OlliL/P8000_WDC_Emulator/performance.txt

----------------------- SD-Card Apacer SD 60x 2GB ----------------------- 
AP2GSD60
540824525053
S482C002GRFBB
0823080523092

=== P8000 WDC Emulator 2.10 - 2016-06-26 ===
INFO: SDCard init start
INFO: SD2.0 disk with byte addressing has been found
INFO: Performance Measurement.
Test Read 5000 512B-Blocks with Multiblock-Read (4KB Blocksize):
536.583070 KiB/sec
536.659850 KiB/sec
Test Write 5000 512B-Blocks with Singleblock-Write (512B Blocksize):
90.717392 KiB/sec
92.806076 KiB/sec
Test Read 5000 512B-Blocks with Singleblock-Read (512B Blocksize):
380.420990 KiB/sec
380.543240 KiB/sec
Test Write 5000 512B-Blocks with Singleblock-Write (512B Blocksize):
91.719177 KiB/sec
92.618126 KiB/sec
Test Read 5000 512B-Blocks with Multiblock-Read (4KB Blocksize):
543.517640 KiB/sec
543.911870 KiB/sec
Test Write 5000 512B-Blocks with Multiblock-Write (4KB Blocksize):
342.564820 KiB/sec
341.265870 KiB/sec
Test Read 5000 512B-Blocks with Multiblock-Read (4KB Blocksize):
534.899230 KiB/sec
534.899230 KiB/sec
Test Write 5000 512B-Blocks with Singleblock-Write (512B Blocksize):
89.257736 KiB/sec
92.855103 KiB/sec
Test Write 5000 512B-Blocks with Multiblock-Write (4KB Blocksize):
343.915740 KiB/sec
334.951020 KiB/sec
Test Read 5000 512B-Blocks with Singleblock-Read (512B Blocksize):
354.962370 KiB/sec
354.973570 KiB/sec
Test Read 5000 512B-Blocks with Multiblock-Read (4KB Blocksize):
532.897520 KiB/sec
532.859680 KiB/sec
Test Read 5000 512B-Blocks with Singleblock-Read (512B Blocksize):
354.939970 KiB/sec
354.956760 KiB/sec
Test Write 5000 512B-Blocks with Multiblock-Write (4KB Blocksize):
327.821080 KiB/sec
326.167330 KiB/sec
Test Write 5000 512B-Blocks with Singleblock-Write (512B Blocksize):
90.930397 KiB/sec
90.952820 KiB/sec
End

----------------------- SD-Card Transcend SD 2GB ----------------------- 
6451AG 2G 02DS1
1555528 8163

=== P8000 WDC Emulator 2.10 - 2016-06-26 ===
INFO: SDCard init start
INFO: SDSC disk has been found
INFO: Performance Measurement.
Test Read 5000 512B-Blocks with Multiblock-Read (4KB Blocksize):
551.375980 KiB/sec
553.478270 KiB/sec
Test Write 5000 512B-Blocks with Singleblock-Write (512B Blocksize):
122.884340 KiB/sec
123.012660 KiB/sec
Test Read 5000 512B-Blocks with Singleblock-Read (512B Blocksize):
400.256160 KiB/sec
400.249020 KiB/sec
Test Write 5000 512B-Blocks with Singleblock-Write (512B Blocksize):
123.345790 KiB/sec
123.431720 KiB/sec
Test Read 5000 512B-Blocks with Multiblock-Read (4KB Blocksize):
551.849300 KiB/sec
551.876400 KiB/sec
Test Write 5000 512B-Blocks with Multiblock-Write (4KB Blocksize):
519.330630 KiB/sec
519.534550 KiB/sec
Test Read 5000 512B-Blocks with Multiblock-Read (4KB Blocksize):
551.862790 KiB/sec
551.862790 KiB/sec
Test Write 5000 512B-Blocks with Singleblock-Write (512B Blocksize):
123.689580 KiB/sec
123.783480 KiB/sec
Test Write 5000 512B-Blocks with Multiblock-Write (4KB Blocksize):
519.414550 KiB/sec
519.654480 KiB/sec
Test Read 5000 512B-Blocks with Singleblock-Read (512B Blocksize):
400.249020 KiB/sec
400.256160 KiB/sec
Test Read 5000 512B-Blocks with Multiblock-Read (4KB Blocksize):
551.849300 KiB/sec
551.862790 KiB/sec
Test Read 5000 512B-Blocks with Singleblock-Read (512B Blocksize):
400.241910 KiB/sec
400.227660 KiB/sec
Test Write 5000 512B-Blocks with Multiblock-Write (4KB Blocksize):
519.810550 KiB/sec
519.810550 KiB/sec
Test Write 5000 512B-Blocks with Singleblock-Write (512B Blocksize):
123.924610 KiB/sec
124.016820 KiB/sec
End

----------------------- MicroSD-Card  2GB ----------------------- 
MMAGR02GUECA-MB
F6910000 052

=== P8000 WDC Emulator 2.10 - 2016-06-26 ===
INFO: SDCard init start
INFO: SD2.0 disk with byte addressing has been found
INFO: Performance Measurement.
Test Read 5000 512B-Blocks with Multiblock-Read (4KB Blocksize):
369.640230 KiB/sec
369.609860 KiB/sec
Test Write 5000 512B-Blocks with Singleblock-Write (512B Blocksize):
71.321930 KiB/sec
72.334236 KiB/sec
Test Read 5000 512B-Blocks with Singleblock-Read (512B Blocksize):
258.383120 KiB/sec
258.590970 KiB/sec
Test Write 5000 512B-Blocks with Singleblock-Write (512B Blocksize):
72.570580 KiB/sec
72.619537 KiB/sec
Test Read 5000 512B-Blocks with Multiblock-Read (4KB Blocksize):
394.688350 KiB/sec
395.041780 KiB/sec
Test Write 5000 512B-Blocks with Multiblock-Write (4KB Blocksize):
199.434490 KiB/sec
199.512300 KiB/sec
Test Read 5000 512B-Blocks with Multiblock-Read (4KB Blocksize):
401.191070 KiB/sec
401.198210 KiB/sec
Test Write 5000 512B-Blocks with Singleblock-Write (512B Blocksize):
72.569412 KiB/sec
72.650955 KiB/sec
Test Write 5000 512B-Blocks with Multiblock-Write (4KB Blocksize):
199.411510 KiB/sec
199.208480 KiB/sec
Test Read 5000 512B-Blocks with Singleblock-Read (512B Blocksize):
263.969880 KiB/sec
263.969880 KiB/sec
Test Read 5000 512B-Blocks with Multiblock-Read (4KB Blocksize):
400.998020 KiB/sec
401.005190 KiB/sec
Test Read 5000 512B-Blocks with Singleblock-Read (512B Blocksize):
263.963680 KiB/sec
263.979160 KiB/sec
Test Write 5000 512B-Blocks with Multiblock-Write (4KB Blocksize):
199.950230 KiB/sec
199.888060 KiB/sec
Test Write 5000 512B-Blocks with Singleblock-Write (512B Blocksize):
72.690849 KiB/sec
72.723511 KiB/sec
End

----------------------- SD-Card Kingston 512MB ----------------------- 
30330 - 026.A0OLF P775692X02
0532 TM4269M

=== P8000 WDC Emulator 2.10 - 2016-06-26 ===
INFO: SDCard init start
INFO: SDSC disk has been found
INFO: Performance Measurement.
Test Read 5000 512B-Blocks with Multiblock-Read (4KB Blocksize):
602.167790 KiB/sec
602.183900 KiB/sec
Test Write 5000 512B-Blocks with Singleblock-Write (512B Blocksize):
156.103650 KiB/sec
157.192080 KiB/sec
Test Read 5000 512B-Blocks with Singleblock-Read (512B Blocksize):
514.897710 KiB/sec
515.145320 KiB/sec
Test Write 5000 512B-Blocks with Singleblock-Write (512B Blocksize):
157.380080 KiB/sec
157.388870 KiB/sec
Test Read 5000 512B-Blocks with Multiblock-Read (4KB Blocksize):
601.684690 KiB/sec
602.006710 KiB/sec
Test Write 5000 512B-Blocks with Multiblock-Write (4KB Blocksize):
561.223210 KiB/sec
561.783750 KiB/sec
Test Read 5000 512B-Blocks with Multiblock-Read (4KB Blocksize):
601.990600 KiB/sec
601.990600 KiB/sec
Test Write 5000 512B-Blocks with Singleblock-Write (512B Blocksize):
156.972730 KiB/sec
157.362470 KiB/sec
Test Write 5000 512B-Blocks with Multiblock-Write (4KB Blocksize):
560.189270 KiB/sec
560.426450 KiB/sec
Test Read 5000 512B-Blocks with Singleblock-Read (512B Blocksize):
515.145320 KiB/sec
515.157040 KiB/sec
Test Read 5000 512B-Blocks with Multiblock-Read (4KB Blocksize):
602.006710 KiB/sec
602.006710 KiB/sec
Test Read 5000 512B-Blocks with Singleblock-Read (512B Blocksize):
515.133480 KiB/sec
515.157040 KiB/sec
Test Write 5000 512B-Blocks with Multiblock-Write (4KB Blocksize):
561.237240 KiB/sec
561.237240 KiB/sec
Test Write 5000 512B-Blocks with Singleblock-Write (512B Blocksize):
157.227220 KiB/sec
157.303070 KiB/sec
End

----------------------- SD-Card Kingston Elite Pro 512MB ----------------------- 
9930330-018.A00
D000  BK5FA108455

=== P8000 WDC Emulator 2.10 - 2016-06-26 ===
INFO: SDCard init start
INFO: SDSC disk has been found
INFO: Performance Measurement.
Test Read 5000 512B-Blocks with Multiblock-Read (4KB Blocksize):
522.296200 KiB/sec
522.320500 KiB/sec
Test Write 5000 512B-Blocks with Singleblock-Write (512B Blocksize):
106.031550 KiB/sec
107.631810 KiB/sec
Test Read 5000 512B-Blocks with Singleblock-Read (512B Blocksize):
343.333220 KiB/sec
343.506230 KiB/sec
Test Write 5000 512B-Blocks with Singleblock-Write (512B Blocksize):
107.716320 KiB/sec
107.695180 KiB/sec
Test Read 5000 512B-Blocks with Multiblock-Read (4KB Blocksize):
521.811770 KiB/sec
522.211360 KiB/sec
Test Write 5000 512B-Blocks with Multiblock-Write (4KB Blocksize):
392.232060 KiB/sec
392.889590 KiB/sec
Test Read 5000 512B-Blocks with Multiblock-Read (4KB Blocksize):
522.199280 KiB/sec
522.211360 KiB/sec
Test Write 5000 512B-Blocks with Singleblock-Write (512B Blocksize):
107.267490 KiB/sec
107.908490 KiB/sec
Test Write 5000 512B-Blocks with Multiblock-Write (4KB Blocksize):
391.188660 KiB/sec
392.814120 KiB/sec
Test Read 5000 512B-Blocks with Singleblock-Read (512B Blocksize):
343.459010 KiB/sec
343.469480 KiB/sec
Test Read 5000 512B-Blocks with Multiblock-Read (4KB Blocksize):
522.223570 KiB/sec
522.199280 KiB/sec
Test Read 5000 512B-Blocks with Singleblock-Read (512B Blocksize):
343.464230 KiB/sec
343.479980 KiB/sec
Test Write 5000 512B-Blocks with Multiblock-Write (4KB Blocksize):
393.081760 KiB/sec
391.277100 KiB/sec
Test Write 5000 512B-Blocks with Singleblock-Write (512B Blocksize):
107.514040 KiB/sec
107.905400 KiB/sec
End

----------------------- SD-Card SanDisk 256MB ----------------------- 
AR0311NC

=== P8000 WDC Emulator 2.10 - 2016-07-02 ===
INFO: SDCard init start
INFO: SDSC disk has been found
INFO: Performance Measurement.
Test Read 5000 512B-Blocks with Multiblock-Read (4KB Blocksize):
567.823360 KiB/sec
573.000240 KiB/sec
Test Write 5000 512B-Blocks with Singleblock-Write (512B Blocksize):
320.878480 KiB/sec
318.882050 KiB/sec
Test Read 5000 512B-Blocks with Singleblock-Read (512B Blocksize):
496.579130 KiB/sec
496.612000 KiB/sec
Test Write 5000 512B-Blocks with Singleblock-Write (512B Blocksize):
318.863980 KiB/sec
318.909180 KiB/sec
Test Read 5000 512B-Blocks with Multiblock-Read (4KB Blocksize):
573.657650 KiB/sec
573.657650 KiB/sec
Test Write 5000 512B-Blocks with Multiblock-Write (4KB Blocksize):
514.238710 KiB/sec
513.968510 KiB/sec
Test Read 5000 512B-Blocks with Multiblock-Read (4KB Blocksize):
573.657650 KiB/sec
573.657650 KiB/sec
Test Write 5000 512B-Blocks with Singleblock-Write (512B Blocksize):
318.796230 KiB/sec
318.913730 KiB/sec
Test Write 5000 512B-Blocks with Multiblock-Write (4KB Blocksize):
514.121220 KiB/sec
514.132930 KiB/sec
Test Read 5000 512B-Blocks with Singleblock-Read (512B Blocksize):
496.655850 KiB/sec
496.590060 KiB/sec
Test Read 5000 512B-Blocks with Multiblock-Read (4KB Blocksize):
573.672300 KiB/sec
573.672300 KiB/sec
Test Read 5000 512B-Blocks with Singleblock-Read (512B Blocksize):
496.699710 KiB/sec
496.622990 KiB/sec
Test Write 5000 512B-Blocks with Multiblock-Write (4KB Blocksize):
514.226930 KiB/sec
514.309200 KiB/sec
Test Write 5000 512B-Blocks with Singleblock-Write (512B Blocksize):
318.931790 KiB/sec
318.967960 KiB/sec
End

----------------------- SD-Card Kingston 2GB ----------------------- 
P801849
31135-002.A00LF
SD-M02G
0920 T19721D

=== P8000 WDC Emulator 2.10 - 2016-07-02 ===
INFO: SDCard init start
INFO: SD2.0 disk with byte addressing has been found
INFO: Performance Measurement.
Test Read 5000 512B-Blocks with Multiblock-Read (4KB Blocksize):
585.129940 KiB/sec
585.175600 KiB/sec
Test Write 5000 512B-Blocks with Singleblock-Write (512B Blocksize):
61.323109 KiB/sec
56.146549 KiB/sec
Test Read 5000 512B-Blocks with Singleblock-Read (512B Blocksize):
464.137660 KiB/sec
464.616850 KiB/sec
Test Write 5000 512B-Blocks with Singleblock-Write (512B Blocksize):
59.419746 KiB/sec
56.422226 KiB/sec
Test Read 5000 512B-Blocks with Multiblock-Read (4KB Blocksize):
584.749690 KiB/sec
585.662960 KiB/sec
Test Write 5000 512B-Blocks with Multiblock-Write (4KB Blocksize):
379.881500 KiB/sec
318.376710 KiB/sec
Test Read 5000 512B-Blocks with Multiblock-Read (4KB Blocksize):
586.533200 KiB/sec
586.609620 KiB/sec
Test Write 5000 512B-Blocks with Singleblock-Write (512B Blocksize):
55.888542 KiB/sec
55.169640 KiB/sec
Test Write 5000 512B-Blocks with Multiblock-Write (4KB Blocksize):
385.584290 KiB/sec
319.216860 KiB/sec
Test Read 5000 512B-Blocks with Singleblock-Read (512B Blocksize):
466.592040 KiB/sec
466.572630 KiB/sec
Test Read 5000 512B-Blocks with Multiblock-Read (4KB Blocksize):
586.441470 KiB/sec
586.502620 KiB/sec
Test Read 5000 512B-Blocks with Singleblock-Read (512B Blocksize):
466.534000 KiB/sec
466.543610 KiB/sec
Test Write 5000 512B-Blocks with Multiblock-Write (4KB Blocksize):
385.610750 KiB/sec
319.493350 KiB/sec
Test Write 5000 512B-Blocks with Singleblock-Write (512B Blocksize):
56.842152 KiB/sec
55.136112 KiB/sec
End

----------------------- SD-Card CORSAIR 1GB 60x ----------------------- 
SD1GBA0618SEKU4TWN

=== P8000 WDC Emulator 2.10 - 2016-07-02 ===
INFO: SDCard init start
INFO: SDSC disk has been found
INFO: Performance Measurement.
Test Read 5000 512B-Blocks with Multiblock-Read (4KB Blocksize):
609.557800 KiB/sec
613.062320 KiB/sec
Test Write 5000 512B-Blocks with Singleblock-Write (512B Blocksize):
507.579830 KiB/sec
507.431030 KiB/sec
Test Read 5000 512B-Blocks with Singleblock-Read (512B Blocksize):
548.419310 KiB/sec
548.446040 KiB/sec
Test Write 5000 512B-Blocks with Singleblock-Write (512B Blocksize):
508.198940 KiB/sec
508.072690 KiB/sec
Test Read 5000 512B-Blocks with Multiblock-Read (4KB Blocksize):
[no further output]

2nd try:

=== P8000 WDC Emulator 2.10 - 2016-07-02 ===
INFO: SDCard init start
INFO: SDSC disk has been found
INFO: Performance Measurement.
Test Read 5000 512B-Blocks with Multiblock-Read (4KB Blocksize):
369.033970 KiB/sec
274.022670 KiB/sec
Test Write 5000 512B-Blocks with Singleblock-Write (512B Blocksize):
505.390840 KiB/sec
507.717320 KiB/sec
Test Read 5000 512B-Blocks with Singleblock-Read (512B Blocksize):
548.432680 KiB/sec
548.459410 KiB/sec
Test Write 5000 512B-Blocks with Singleblock-Write (512B Blocksize):
508.141540 KiB/sec
508.095640 KiB/sec
Test Read 5000 512B-Blocks with Multiblock-Read (4KB Blocksize):
575.933650 KiB/sec
612.911990 KiB/sec
Test Write 5000 512B-Blocks with Multiblock-Write (4KB Blocksize):
647.780270 KiB/sec
647.742980 KiB/sec
Test Read 5000 512B-Blocks with Multiblock-Read (4KB Blocksize):
612.945370 KiB/sec
612.911990 KiB/sec
Test Write 5000 512B-Blocks with Singleblock-Write (512B Blocksize):
508.084170 KiB/sec
508.130070 KiB/sec
Test Write 5000 512B-Blocks with Multiblock-Write (4KB Blocksize):
647.742980 KiB/sec
647.742980 KiB/sec
Test Read 5000 512B-Blocks with Singleblock-Read (512B Blocksize):
548.512880 KiB/sec
548.526310 KiB/sec
Test Read 5000 512B-Blocks with Multiblock-Read (4KB Blocksize):
448.689820 KiB/sec
612.995480 KiB/sec
Test Read 5000 512B-Blocks with Singleblock-Read (512B Blocksize):
548.512880 KiB/sec
548.526310 KiB/sec
Test Write 5000 512B-Blocks with Multiblock-Write (4KB Blocksize):
647.780270 KiB/sec
647.798950 KiB/sec
Test Write 5000 512B-Blocks with Singleblock-Write (512B Blocksize):
508.164490 KiB/sec
508.198940 KiB/sec
End

----------------------- SD-Card SanDisk 2GB ----------------------- 

=== P8000 WDC Emulator 2.10 - 2016-07-02 ===
INFO: SDCard init start
INFO: SD2.0 disk with byte addressing has been found
INFO: Performance Measurement.
Test Read 5000 512B-Blocks with Multiblock-Read (4KB Blocksize):
570.255490 KiB/sec
570.298830 KiB/sec
Test Write 5000 512B-Blocks with Singleblock-Write (512B Blocksize):
245.413500 KiB/sec
243.633060 KiB/sec
Test Read 5000 512B-Blocks with Singleblock-Read (512B Blocksize):
458.061860 KiB/sec
458.164460 KiB/sec
Test Write 5000 512B-Blocks with Singleblock-Write (512B Blocksize):
244.419100 KiB/sec
243.688480 KiB/sec
Test Read 5000 512B-Blocks with Multiblock-Read (4KB Blocksize):
571.573730 KiB/sec
571.588260 KiB/sec
Test Write 5000 512B-Blocks with Multiblock-Write (4KB Blocksize):
512.236760 KiB/sec
526.993770 KiB/sec
Test Read 5000 512B-Blocks with Multiblock-Read (4KB Blocksize):
571.617310 KiB/sec
571.602780 KiB/sec
Test Write 5000 512B-Blocks with Singleblock-Write (512B Blocksize):
244.977950 KiB/sec
243.886580 KiB/sec
Test Write 5000 512B-Blocks with Multiblock-Write (4KB Blocksize):
528.131840 KiB/sec
528.230960 KiB/sec
Test Read 5000 512B-Blocks with Singleblock-Read (512B Blocksize):
458.192500 KiB/sec
458.220460 KiB/sec
Test Read 5000 512B-Blocks with Multiblock-Read (4KB Blocksize):
571.602780 KiB/sec
571.631770 KiB/sec
Test Read 5000 512B-Blocks with Singleblock-Read (512B Blocksize):
458.332490 KiB/sec
458.239140 KiB/sec
Test Write 5000 512B-Blocks with Multiblock-Write (4KB Blocksize):
513.148010 KiB/sec
527.636410 KiB/sec
Test Write 5000 512B-Blocks with Singleblock-Write (512B Blocksize):
247.144130 KiB/sec
246.962360 KiB/sec
End

----------------------- MicroSD-Card Kingston 8GB ----------------------- 
C08G CHINA
123PV9029P
SDC4/8GB 074

=== P8000 WDC Emulator 2.10 - 2016-07-02 ===
INFO: SDCard init start
INFO: SD2.0 disk with block addressing has been found
INFO: Performance Measurement.
Test Read 5000 512B-Blocks with Multiblock-Read (4KB Blocksize):
588.650760 KiB/sec
588.696960 KiB/sec
Test Write 5000 512B-Blocks with Singleblock-Write (512B Blocksize):
146.073530 KiB/sec
133.962050 KiB/sec
Test Read 5000 512B-Blocks with Singleblock-Read (512B Blocksize):
332.584410 KiB/sec
332.692600 KiB/sec
Test Write 5000 512B-Blocks with Singleblock-Write (512B Blocksize):
133.634250 KiB/sec
133.332550 KiB/sec
Test Read 5000 512B-Blocks with Multiblock-Read (4KB Blocksize):
514.356320 KiB/sec
514.591490 KiB/sec
Test Write 5000 512B-Blocks with Multiblock-Write (4KB Blocksize):
294.857670 KiB/sec
331.652950 KiB/sec
Test Read 5000 512B-Blocks with Multiblock-Read (4KB Blocksize):
513.686890 KiB/sec
513.628230 KiB/sec
Test Write 5000 512B-Blocks with Singleblock-Write (512B Blocksize):
135.556050 KiB/sec
133.757400 KiB/sec
Test Write 5000 512B-Blocks with Multiblock-Write (4KB Blocksize):
319.865780 KiB/sec
331.887790 KiB/sec
Test Read 5000 512B-Blocks with Singleblock-Read (512B Blocksize):
333.269170 KiB/sec
333.160580 KiB/sec
Test Read 5000 512B-Blocks with Multiblock-Read (4KB Blocksize):
514.615110 KiB/sec
514.638610 KiB/sec
Test Read 5000 512B-Blocks with Singleblock-Read (512B Blocksize):
333.126040 KiB/sec
333.071810 KiB/sec
Test Write 5000 512B-Blocks with Multiblock-Write (4KB Blocksize):
332.599150 KiB/sec
331.829040 KiB/sec
Test Write 5000 512B-Blocks with Singleblock-Write (512B Blocksize):
133.630280 KiB/sec
133.783630 KiB/sec
End

----------------------- MicroSD-Card Verbatim 8GB ----------------------- 
E508G1511
TFLN002794138

=== P8000 WDC Emulator 2.10 - 2016-07-02 ===
INFO: SDCard init start
INFO: SD2.0 disk with block addressing has been found
INFO: Performance Measurement.
Test Read 5000 512B-Blocks with Multiblock-Read (4KB Blocksize):
563.471980 KiB/sec
[no further output]

2nd try:

=== P8000 WDC Emulator 2.10 - 2016-07-02 ===
INFO: SDCard init start
INFO: SD2.0 disk with block addressing has been found
INFO: Performance Measurement.
Test Read 5000 512B-Blocks with Multiblock-Read (4KB Blocksize):
550.243290 KiB/sec
550.283750 KiB/sec
Test Write 5000 512B-Blocks with Singleblock-Write (512B Blocksize):
169.861310 KiB/sec
170.093730 KiB/sec
Test Read 5000 512B-Blocks with Singleblock-Read (512B Blocksize):
375.638610 KiB/sec
375.651120 KiB/sec
Test Write 5000 512B-Blocks with Singleblock-Write (512B Blocksize):
170.066740 KiB/sec
169.739580 KiB/sec
Test Read 5000 512B-Blocks with Multiblock-Read (4KB Blocksize):
551.971190 KiB/sec
552.120180 KiB/sec
Test Write 5000 512B-Blocks with Multiblock-Write (4KB Blocksize):
291.885590 KiB/sec
289.013610 KiB/sec
Test Read 5000 512B-Blocks with Multiblock-Read (4KB Blocksize):
553.287720 KiB/sec
553.260560 KiB/sec
Test Write 5000 512B-Blocks with Singleblock-Write (512B Blocksize):
169.676860 KiB/sec
169.928020 KiB/sec
Test Write 5000 512B-Blocks with Multiblock-Write (4KB Blocksize):
310.019840 KiB/sec
288.854060 KiB/sec
Test Read 5000 512B-Blocks with Singleblock-Read (512B Blocksize):
374.581700 KiB/sec
374.550540 KiB/sec
Test Read 5000 512B-Blocks with Multiblock-Read (4KB Blocksize):
[no further output]

----------------------- MicroSD-Card 8GB ----------------------- 
WWCTR08G3ACH-NJ
L E53067CU 321

=== P8000 WDC Emulator 2.10 - 2016-07-02 ===
INFO: SDCard init start
INFO: SD2.0 disk with block addressing has been found
INFO: Performance Measurement.
Test Read 5000 512B-Blocks with Multiblock-Read (4KB Blocksize):
586.808530 KiB/sec
586.762700 KiB/sec
Test Write 5000 512B-Blocks with Singleblock-Write (512B Blocksize):
244.967290 KiB/sec
265.521180 KiB/sec
Test Read 5000 512B-Blocks with Singleblock-Read (512B Blocksize):
528.752440 KiB/sec
528.864200 KiB/sec
Test Write 5000 512B-Blocks with Singleblock-Write (512B Blocksize):
265.778380 KiB/sec
266.275330 KiB/sec
Test Read 5000 512B-Blocks with Multiblock-Read (4KB Blocksize):
599.616210 KiB/sec
599.776120 KiB/sec
Test Write 5000 512B-Blocks with Multiblock-Write (4KB Blocksize):
199.604320 KiB/sec
198.363720 KiB/sec
Test Read 5000 512B-Blocks with Multiblock-Read (4KB Blocksize):
591.311710 KiB/sec
591.342710 KiB/sec
Test Write 5000 512B-Blocks with Singleblock-Write (512B Blocksize):
263.852230 KiB/sec
266.669800 KiB/sec
Test Write 5000 512B-Blocks with Multiblock-Write (4KB Blocksize):
197.306110 KiB/sec
190.373050 KiB/sec
Test Read 5000 512B-Blocks with Singleblock-Read (512B Blocksize):
500.545040 KiB/sec
500.478210 KiB/sec
Test Read 5000 512B-Blocks with Multiblock-Read (4KB Blocksize):
590.985470 KiB/sec
590.985470 KiB/sec
Test Read 5000 512B-Blocks with Singleblock-Read (512B Blocksize):
500.455990 KiB/sec
500.467070 KiB/sec
Test Write 5000 512B-Blocks with Multiblock-Write (4KB Blocksize):
199.354980 KiB/sec
191.055220 KiB/sec
Test Write 5000 512B-Blocks with Singleblock-Write (512B Blocksize):
266.001460 KiB/sec
267.068630 KiB/sec
End

----------------------- SD-Card Kingston 8GB ----------------------- 
31741-001-A00LF
P1118871
SD-K08G
1547
WL67176

=== P8000 WDC Emulator 2.10 - 2016-07-02 ===
INFO: SDCard init start
INFO: SD2.0 disk with block addressing has been found
INFO: Performance Measurement.
Test Read 5000 512B-Blocks with Multiblock-Read (4KB Blocksize):
593.745850 KiB/sec
593.777220 KiB/sec
Test Write 5000 512B-Blocks with Singleblock-Write (512B Blocksize):
136.982970 KiB/sec
136.441360 KiB/sec
Test Read 5000 512B-Blocks with Singleblock-Read (512B Blocksize):
380.923370 KiB/sec
380.923370 KiB/sec
Test Write 5000 512B-Blocks with Singleblock-Write (512B Blocksize):
136.134280 KiB/sec
134.135380 KiB/sec
Test Read 5000 512B-Blocks with Multiblock-Read (4KB Blocksize):
554.023440 KiB/sec
554.241760 KiB/sec
Test Write 5000 512B-Blocks with Multiblock-Write (4KB Blocksize):
266.398320 KiB/sec
262.243900 KiB/sec
Test Read 5000 512B-Blocks with Multiblock-Read (4KB Blocksize):
562.851810 KiB/sec
562.795470 KiB/sec
Test Write 5000 512B-Blocks with Singleblock-Write (512B Blocksize):
136.763150 KiB/sec
136.510090 KiB/sec
Test Write 5000 512B-Blocks with Multiblock-Write (4KB Blocksize):
264.059720 KiB/sec
263.124020 KiB/sec
Test Read 5000 512B-Blocks with Singleblock-Read (512B Blocksize):
377.548430 KiB/sec
377.333160 KiB/sec
Test Read 5000 512B-Blocks with Multiblock-Read (4KB Blocksize):
557.413570 KiB/sec
557.344540 KiB/sec
Test Read 5000 512B-Blocks with Singleblock-Read (512B Blocksize):
376.991760 KiB/sec
376.878110 KiB/sec
Test Write 5000 512B-Blocks with Multiblock-Write (4KB Blocksize):
261.621830 KiB/sec
250.855700 KiB/sec
Test Write 5000 512B-Blocks with Singleblock-Write (512B Blocksize):
136.617000 KiB/sec
136.486050 KiB/sec
End

----------------------- SD-Card Intenso 8GB ----------------------- 
(Intenso)
SDHC
MEMORY CARD
Class 10

S708K1601
TFLKA61026A02

=== P8000 WDC Emulator 2.10 - 2016-07-02 ===
INFO: SDCard init start
INFO: SD2.0 disk with block addressing has been found
INFO: Performance Measurement.
Test Read 5000 512B-Blocks with Multiblock-Read (4KB Blocksize):
592.292300 KiB/sec
592.307860 KiB/sec
Test Write 5000 512B-Blocks with Singleblock-Write (512B Blocksize):
171.412900 KiB/sec
176.174880 KiB/sec
Test Read 5000 512B-Blocks with Singleblock-Read (512B Blocksize):
374.569240 KiB/sec
374.519380 KiB/sec
Test Write 5000 512B-Blocks with Singleblock-Write (512B Blocksize):
176.458130 KiB/sec
176.163850 KiB/sec
Test Read 5000 512B-Blocks with Multiblock-Read (4KB Blocksize):
552.934200 KiB/sec
553.124510 KiB/sec
Test Write 5000 512B-Blocks with Multiblock-Write (4KB Blocksize):
314.329220 KiB/sec
276.310970 KiB/sec
Test Read 5000 512B-Blocks with Multiblock-Read (4KB Blocksize):
564.560670 KiB/sec
564.603150 KiB/sec
Test Write 5000 512B-Blocks with Singleblock-Write (512B Blocksize):
176.155590 KiB/sec
176.169370 KiB/sec
Test Write 5000 512B-Blocks with Multiblock-Write (4KB Blocksize):
314.821840 KiB/sec
291.734190 KiB/sec
Test Read 5000 512B-Blocks with Singleblock-Read (512B Blocksize):
377.795680 KiB/sec
377.744930 KiB/sec
Test Read 5000 512B-Blocks with Multiblock-Read (4KB Blocksize):
557.482600 KiB/sec
557.468810 KiB/sec
Test Read 5000 512B-Blocks with Singleblock-Read (512B Blocksize):
377.662540 KiB/sec
377.592800 KiB/sec
Test Write 5000 512B-Blocks with Multiblock-Write (4KB Blocksize):
292.310270 KiB/sec
277.161830 KiB/sec
Test Write 5000 512B-Blocks with Singleblock-Write (512B Blocksize):
176.010890 KiB/sec
176.563390 KiB/sec
End

----------------------- SD-Card Intenso 4GB ----------------------- 
(Intenso)
SDHC
MEMORY CARD
Class 10

=== P8000 WDC Emulator 2.10 - 2016-07-02 ===
INFO: SDCard init start
INFO: SD2.0 disk with block addressing has been found
INFO: Performance Measurement.
Test Read 5000 512B-Blocks with Multiblock-Read (4KB Blocksize):
602.328980 KiB/sec
602.409610 KiB/sec
Test Write 5000 512B-Blocks with Singleblock-Write (512B Blocksize):
254.248760 KiB/sec
267.106720 KiB/sec
Test Read 5000 512B-Blocks with Singleblock-Read (512B Blocksize):
442.608460 KiB/sec
442.625820 KiB/sec
Test Write 5000 512B-Blocks with Singleblock-Write (512B Blocksize):
267.030610 KiB/sec
268.496400 KiB/sec
Test Read 5000 512B-Blocks with Multiblock-Read (4KB Blocksize):
567.279300 KiB/sec
567.307920 KiB/sec
Test Write 5000 512B-Blocks with Multiblock-Write (4KB Blocksize):
502.782040 KiB/sec
508.198940 KiB/sec
Test Read 5000 512B-Blocks with Multiblock-Read (4KB Blocksize):
566.993410 KiB/sec
567.022030 KiB/sec
Test Write 5000 512B-Blocks with Singleblock-Write (512B Blocksize):
266.470860 KiB/sec
270.078860 KiB/sec
Test Write 5000 512B-Blocks with Multiblock-Write (4KB Blocksize):
498.107180 KiB/sec
508.486080 KiB/sec
Test Read 5000 512B-Blocks with Singleblock-Read (512B Blocksize):
441.999790 KiB/sec
442.034520 KiB/sec
Test Read 5000 512B-Blocks with Multiblock-Read (4KB Blocksize):
567.022030 KiB/sec
567.007750 KiB/sec
Test Read 5000 512B-Blocks with Singleblock-Read (512B Blocksize):
441.999790 KiB/sec
441.999790 KiB/sec
Test Write 5000 512B-Blocks with Multiblock-Write (4KB Blocksize):
517.967710 KiB/sec
507.958010 KiB/sec
Test Write 5000 512B-Blocks with Singleblock-Write (512B Blocksize):
268.118900 KiB/sec
270.722290 KiB/sec
End
