OlliL/P8000_WDC_Emulator/P8000_WDC_Emulator/Hardware/P8000_WDC_Emulator_Parts.ods

Sheet: Sheet1
Stückliste P8000 WDC Emulator v2.1.1 |  |  |  | einzeln
Reichelt Art-Nr | Schaltplan | Bezeichnung | EVP | Menge | Gesamt
Z5U-2,5 100N | C1 | Vielschicht-Keramikkondensator 100N, 20% | 0,04 € | 8 | 0,32 €
RAD 470/16 | C2 | Elektrolytkondensator, 10x12,5mm, RM 5,0mm | 0,04 € | 1 | 0,04 €
RAD 100/16 | C3 | Elektrolytkondensator, 5x11mm, RM 2,0mm | 0,04 € | 2 | 0,08 €
SM 1,0/63RAD | C4 | Subminiatur-Elko, radial, 1,0µF/63Volt | 0,04 € | 4 | 0,16 €
KERKO 22P | C6 | Keramik-Kondensator 22P | 0,06 € | 2 | 0,12 €
ATMEGA 1284P-PU | D1 | ATMEL AtMega-AVR, PDIP-40 | 7,45 € | 1 | 7,45 €
MAX 232 CPE | D2 | RS232, DIP-16 | 0,39 € | 1 | 0,39 €
TS 1117 BCW33 | D3 | TS 1117 BCW33 | 0,30 € | 1 | 0,30 €
74HCT 00 | D4 | 74HCT 00 | 0,33 € | 1 | 0,33 €
74HCT 245 | D5 | 74HCT 245 | 0,33 € | 1 | 0,33 €
74HCT 243 | D6 | 74HCT 243 | 0,38 € | 1 | 0,38 €
74HCT 573 | D7 | 74HCT 573 | 0,30 € | 1 | 0,30 €
LED 5MM GN | L1 | LED, 5mm, Low Cost, grün | 0,06 € | 2 | 0,12 €
SIL 8-4 1,8K | R1 | Widerstands-Netzwerk, 4Wid./8Pins, 1,8 K-Ohm | 0,07 € | 1 | 0,07 €
SIL 5-4 3,3K | R2 | Widerstands-Netzwerk, 4Wid./5Pins, 3,3 K-Ohm | 0,06 € | 1 | 0,06 €
METALL 10,0K | R3 | Metallschichtwiderstand 10,0 K-Ohm | 0,08 € | 1 | 0,08 €
METALL 300 | R4 | Metallschichtwiderstand 300 Ohm | 0,08 € | 2 | 0,16 €
METALL 4,70K | R5 | Metallschichtwiderstand 4,7 K-Ohm | 0,08 € | 1 | 0,08 €
CONNECTOR SD 21 | X3 | MMC- und SD-Card Connector, 9pol. | 4,55 € | 1 | 4,55 €
SL 2X40G 2,54 | X1, X2/X6, X4, X7, JP1 | 2x40pol.-Stiftleiste, gerade, RM 2,54 | 0,24 € | 1,4 | 0,48 €
PSW 5 | X5 | Stromversorgungsstecker f. 5 1/4 Zoll, Print, gew. | 0,32 € | 1 | 0,32 €
1N 4148 | VD1 | Diode 1N 4148 | 0,04 € | 1 | 0,04 €
18,4320-HC49U-S | Q1 | Standardquarz, Grundton, 18,4320 MHz | 0,23 € | 1 | 0,23 €
TASTER 3301 | SW1 | Kurzhubtaster 6x6mm, Höhe: 4,3mm, 12V, vertikal | 0,12 € | 1 | 0,12 €
- | - | Leiterplatte 144mm x 160,4mm |  | 1 | 0,00 €
- | - | Versand & Verpackung durch Reichelt | 5,60 € | 1 | 5,60 €
 |  |  | ∑ | 38,4 | 22,12 €
 |  |  |  | 28.08.2016

Sheet: Sheet2
5
20
13
13
3
1
55
