OlliL/P8000_WDC_Emulator/P8000_WDC_Emulator/Hardware/P8000_WDC_Emulator.sch

## KiCad design P8000_WDC_Emulator/Hardware/P8000_WDC_Emulator.sch (2016-08-27, an earlier design)

Schematic: P8000_WDC_Emulator.sch

Parts:
1C1, 2C1, 3C1, 4C1, 5C1, 6C1, 7C1, 8C1: 100n; C_Disc_D3_P2.5
1C3, 2C3: 100u; C_Radial_D5_L6_P2.5
1C4, 2C4, 3C4, 4C4: 1u; C_Radial_D5_L6_P2.5
1C6, 2C6: 22p; C_Disc_D3_P2.5
1L1, 2L1: LED; LED-5MM
1R4, 2R4: 300; R1
C2: 470u; C_Radial_D8_L13_P3.8
D1: ATMEGA1284-P; DIP-40_W15.24mm
D2: MAX232; DIP-16_W7.62mm
D3: TS1117 BCW33; SOT-223
D4: 74HCT00; DIP-14_W7.62mm
D5: 74HCT245; DIP-20_W7.62mm
D6: 74HCT243; DIP-14_W7.62mm
D7: 74HCT573; DIP-20_W7.62mm
JP1: JUMPER; Pin_Header_Straight_1x02
Q1: CRYSTAL; Crystal_HC49-U_Vertical
R1: 1k8; Pin_Header_Straight_1x08
R2: 3k3; Pin_Header_Straight_1x05
R3: 10k; R1
R5: 4k7; Resistor_Vertical_RM5mm
SW1: SW_PUSH; SW_6x6
VD1: 1N4148; D3
X1: RS-232; Pin_Header_Straight_2x05
X2: P8000; Pin_Header_Straight_2x13
X3: SD-CON; sd_cocket_yamaichi_fps009_3001
X4: PATA; Pin_Header_Straight_2x20
X5: 4_Pin_Molex; 4PIN_MOLEX
X6: P8000-Compact; Pin_Header_Straight_2x13
X7: AVR-ISP-6; Pin_Header_Straight_2x03

Notes on the sheet:
(keypin)
CSEL
GND
DMARQ
/IOCS16
/PDIAG
INTRQ
IORDY
/DASP
/CS0
DA0
DA1
/DMACK
/DIOR
/DIOW
DD0
DD1
DD2
DD3
DD4
DD5
DD6
DD7
/RESET
/CS1
DA2
DD15
DD14
DD13
DD12
DD11
DD10
DD9
DD8
Abblockkondensator übernimmt C7 mit
