OlliL/P8000_WDC_Emulator/P8000_WDC_Emulator/wdc_main.c

/*-
 * Copyright (c) 2012, 2013, 2015, 2016 Oliver Lehmann
 * All rights reserved.
 *
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
 */

/* Right now, BTT entries are ignored and not considered when reading or writing to a disk */

#include "wdc_config.h"
#include <string.h>
#include <stdlib.h>
#include <stdbool.h>
#include <avr/pgmspace.h>
#include <avr/sleep.h>
#include <avr/interrupt.h>
#include <util/delay.h>
#include "wdc_main.h"
#ifdef DEBUG
#include "uart.h"
#endif
#include "wdc_avr.h"
#include "wdc_ram.h"
#include "wdc_par.h"
#include "wdc_if_p8000.h"
#include "wdc_if_disk.h"

static void atmega_setup ( void );

#ifdef MEASURE_DISK_PERFORMANCE
extern void measure_performance ();
#else
/* switched from local to global for keeping an eye on memory usage */
static uint8_t       data_buffer[4096];
static uint8_t       cmd_buffer[9];
static const uint8_t wdc_ver_string[] PROGMEM = { 'W', 'D', 'C', '_', '4', '.', '2' };
#endif

int __attribute__( ( OS_main ) )
main ( void )
{
#ifndef MEASURE_DISK_PERFORMANCE
    uint16_t data_counter;
    uint32_t blockno;
    uint8_t  errorcode;
    uint8_t  i8;
#endif

    atmega_setup();

#ifdef MEASURE_DISK_PERFORMANCE
    if ( wdc_get_disk_valid()) {
        measure_performance();
    }
#else

    /* load Parameter Table into RAM if valid */
    if ( wdc_get_disk_valid() ) {
        blockno = 0;
        errorcode = wdc_read_sector ( blockno, data_buffer );

        if ( errorcode == 0 ) {
            for ( i8 = 0; i8 <= 6; i8++ ) {
                if ( data_buffer[i8] != (uint8_t)pgm_read_byte_near ( wdc_ver_string + i8 )) {
                    errorcode = 1;
                    break;
                }
            }

            if ( errorcode == 0 ) {
                wdc_write_par_table ( data_buffer, WDC_BLOCKLEN );
                wdc_set_disk_valid();

                uart_putstring ( PSTR ( "INFO: Disk found and ready to use." ), true );
                uart_putstring ( PSTR ( "INFO: Heads: " ), false );
                uart_putw_dec ( wdc_get_hdd_heads());
                uart_put_nl();

                uart_putstring ( PSTR ( "INFO: Cylinders: " ), false );
                uart_putw_dec ( wdc_get_hdd_cylinder());
                uart_put_nl();

                uart_putstring ( PSTR ( "INFO: Sectors: " ), false );
                uart_putw_dec ( wdc_get_hdd_sectors());
                uart_put_nl();

                uart_putstring ( PSTR ( "INFO: Blocks: " ), false );
                uart_putdw_dec ( wdc_get_hdd_blocks());
                uart_put_nl();

                uart_putstring ( PSTR ( "INFO: Useable blocks: " ), false );
                uart_putdw_dec ( wdc_get_hdd_blocks() - ((uint32_t)wdc_get_hdd_heads() * (uint32_t)wdc_get_hdd_sectors()));
                uart_put_nl();
            } else {
                uart_putstring ( PSTR ( "INFO: Disk found but Sector 0 is invalid, please execute sa.format to initialize this disk properly." ), true );
                wdc_set_disk_invalid();
            }
        } else {
            uart_putstring ( PSTR ( "INFO: Disk found but Sector 0 can not be read!" ), true );
            wdc_set_no_disk();
        }
    }

    while ( true ) {

        if ( wdc_receive_cmd ( cmd_buffer ) ) {

#if DEBUG >= 2
#if DEBUG >= 4
            uart_putstring ( PSTR ( "DEBUG: received command is: " ), false );
#endif
            uart_putc_hex ( cmd_buffer[0] );
#if DEBUG >= 3
            uart_putc_hex ( cmd_buffer[1] );
            uart_putc_hex ( cmd_buffer[2] );
            uart_putc_hex ( cmd_buffer[3] );
            uart_putc_hex ( cmd_buffer[4] );
            uart_putc_hex ( cmd_buffer[5] );
            uart_putc_hex ( cmd_buffer[6] );
            uart_putc_hex ( cmd_buffer[7] );
            uart_putc_hex ( cmd_buffer[8] );
#endif
            uart_put_nl();
#endif

            /* drive problems - error occurs on the first command only*/
            if ( wdc_get_initialized() ) {
                wdc_unset_initialized();
                if ( wdc_get_num_of_drvs() == 0 ) {
                    wdc_send_errorcode ( ERR_NO_DRIVE_READY );
                    continue;
                } else if ( !wdc_get_disk_valid()) {
                    wdc_send_errorcode ( ERR_CYL0_NOT_READABLE );
                    continue;
                }
            }

            /* if the disk is not valid, only maintenance commands are allowed */
            if ( wdc_get_num_of_drvs() > 0 && !wdc_get_disk_valid()
                 && cmd_buffer[0] != CMD_RD_WDC_RAM
                 && cmd_buffer[0] != CMD_FMTRD_TRACK
                 && cmd_buffer[0] != CMD_WR_WDC_RAM
                 && cmd_buffer[0] != CMD_FMTBTT_TRACK
                 && cmd_buffer[0] != CMD_RD_PARTAB
                 && cmd_buffer[0] != CMD_RD_WDCERR
                 && cmd_buffer[0] != CMD_DL_BTTAB
                 && !( cmd_buffer[0] == CMD_RD_BTTAB && wdc_get_btt_cleared())
                 && cmd_buffer[0] != CMD_WR_BTTAB
                 && cmd_buffer[0] != CMD_WR_PARTAB
                 && cmd_buffer[0] != CMD_ST_PARBTT
               ) {
                if ( cmd_buffer[0] == CMD_RD_BLOCK
                     || cmd_buffer[0] == CMD_WR_BLOCK
                     || cmd_buffer[0] == CMD_RD_SECTOR
                     || cmd_buffer[0] == CMD_WR_SECTOR ) {
                    wdc_send_errorcode ( ERR_NO_MARK_FOUND );
                } else if ( cmd_buffer[0] == CMD_RD_BTTAB ) {
                    wdc_send_errorcode ( ERR_BTT_INVALID );
                } else if ( cmd_buffer[0] == CMD_VER_TRACK ) {
                    wdc_send_errorcode ( ERR_DUR_TIM_CONST_CLC );
                } else {
                    wdc_send_error();
                }
                /* if the specified drive exceeds the number of drives, no drive commands are allowed */
            } else if ( cmd_buffer[1] >= wdc_get_num_of_drvs()
                        && ( cmd_buffer[0] == CMD_RD_SECTOR
                             || cmd_buffer[0] == CMD_FMTRD_TRACK
                             || cmd_buffer[0] == CMD_WR_SECTOR
                             || cmd_buffer[0] == CMD_RD_BLOCK
                             || cmd_buffer[0] == CMD_WR_BLOCK
                             || cmd_buffer[0] == CMD_FMTBTT_TRACK
                             || cmd_buffer[0] == CMD_VER_TRACK
                             || ( cmd_buffer[0] == CMD_RD_BTTAB && !wdc_get_btt_cleared() )
                           )
                      ) {
                if ( cmd_buffer[0] == CMD_RD_BTTAB ) {
                    wdc_send_errorcode ( ERR_BTT_INVALID );
                } else {
                    wdc_send_errorcode ( ERR_DRIVE_NOT_READY );
                }
            } else {
                switch ( cmd_buffer[0] ) {
                    case CMD_WR_BLOCK:
                        data_counter = ( cmd_buffer[7] << 8 ) | cmd_buffer[6];

                        blockno = wdc_p8kblock2diskblock ( ( (uint32_t)cmd_buffer[5] << 24 ) | ( (uint32_t)cmd_buffer[4] << 16 ) | ( (uint16_t)cmd_buffer[3] << 8 ) | cmd_buffer[2] );
                        errorcode = wdc_validate_blockno ( blockno );

                        wdc_receive_data ( data_buffer
                                         , data_counter
                                         );

                        if ( errorcode != 0 ) {
                            wdc_send_errorcode ( errorcode );
                            break;
                        }

                        if ( data_counter == WDC_BLOCKLEN ) {
                            errorcode = wdc_write_sector ( blockno, data_buffer );
                        } else {
                            errorcode = wdc_write_multiblock ( blockno, data_buffer, data_counter / WDC_BLOCKLEN );
                        }

                        if ( errorcode > 0 ) {
                            wdc_send_error();
                        }
                        break;

                    case CMD_RD_BLOCK:
                        data_counter = ( cmd_buffer[7] << 8 ) | cmd_buffer[6];

                        blockno = wdc_p8kblock2diskblock ( ( (uint32_t)cmd_buffer[5] << 24 ) | ( (uint32_t)cmd_buffer[4] << 16 ) | ( (uint16_t)cmd_buffer[3] << 8 ) | cmd_buffer[2] );

                        errorcode = wdc_validate_blockno ( blockno );
                        if ( errorcode != 0 ) {
                            wdc_send_errorcode ( errorcode );
                            break;
                        }

                        if ( data_counter == WDC_BLOCKLEN ) {
                            errorcode = wdc_read_sector ( blockno, data_buffer );
                        } else {
                            errorcode = wdc_read_multiblock ( blockno, data_buffer, data_counter / WDC_BLOCKLEN );
                        }

                        if ( errorcode > 0 ) {
                            wdc_send_error();
                        } else {
                            wdc_send_data ( data_buffer
                                          , data_counter
                                          );
                        }
                        break;

                    case CMD_WR_WDC_RAM:
                        data_counter = ( cmd_buffer[7] << 8 ) | cmd_buffer[6];

                        wdc_receive_data ( data_buffer
                                         , data_counter
                                         );

                        wdc_write_data_to_ram ( data_buffer
                                              , convert_ram_address ( ( cmd_buffer[2] << 8 ) | cmd_buffer[1] )
                                              , data_counter
                                              );
                        break;

                    case CMD_RD_WDC_RAM:
                        data_counter = ( cmd_buffer[7] << 8 ) | cmd_buffer[6];

                        wdc_read_data_from_ram ( data_buffer
                                               , convert_ram_address ( ( cmd_buffer[2] << 8 ) | cmd_buffer[1] )
                                               , data_counter
                                               );

                        wdc_send_data ( data_buffer
                                      , data_counter
                                      );

                        wdc_unset_initialized();
                        break;

                    case CMD_RD_PARTAB:
                        data_counter = ( cmd_buffer[7] << 8 ) | cmd_buffer[6];

                        wdc_read_par_table ( data_buffer
                                           , data_counter );

                        wdc_send_data ( data_buffer
                                      , data_counter
                                      );
                        break;

                    case CMD_WR_PARTAB:
                        data_counter = ( cmd_buffer[7] << 8 ) | cmd_buffer[6];

                        wdc_receive_data ( data_buffer
                                         , data_counter
                                         );

                        wdc_write_wdc_par ( data_buffer
                                          , data_counter );
                        break;

                    case CMD_DL_BTTAB:
                        wdc_del_wdc_btt();
                        break;

                    case CMD_RD_BTTAB:
                        data_counter = ( cmd_buffer[7] << 8 ) | cmd_buffer[6];

                        wdc_read_wdc_btt ( data_buffer
                                         , data_counter );

                        wdc_send_data ( data_buffer
                                      , data_counter
                                      );
                        break;

                    case CMD_WR_BTTAB:
                        data_counter = ( cmd_buffer[7] << 8 ) | cmd_buffer[6];

                        wdc_receive_data ( data_buffer
                                         , data_counter
                                         );

                        wdc_write_wdc_btt ( data_buffer
                                          , data_counter );
                        break;

                    case CMD_FMTRD_TRACK:
                    case CMD_FMTBTT_TRACK:

                        /* no cylinder 0 formatting if command is CMD_FMTBTT_TRACK */
                        if ( cmd_buffer[0] == CMD_FMTBTT_TRACK && ( cmd_buffer[2] | ( cmd_buffer[3] << 8 ) ) == 0 ) {
                            break;
                        }

                        memset ( &data_buffer[0], 0x00, WDC_BLOCKLEN );
                        blockno = wdc_sector2diskblock ( cmd_buffer[2] | ( cmd_buffer[3] << 8 )
                                                       , cmd_buffer[4]
                                                       , cmd_buffer[5]
                                                       );
                        errorcode = wdc_validate_cylhead ( cmd_buffer[2] | ( cmd_buffer[3] << 8 ), cmd_buffer[4], blockno );
                        if ( errorcode != 0 ) {
                            wdc_send_errorcode ( errorcode );
                            break;
                        }

                        errorcode = 1;
                        for ( i8 = 0; i8 < wdc_get_hdd_sectors(); i8++ ) {
                            errorcode = wdc_write_sector ( blockno, data_buffer );
                            if ( errorcode > 0 ) {
                                break;
                            }
                            blockno++;
                        }

                        if ( errorcode > 0 ) {
                            if ( cmd_buffer[0] == CMD_FMTRD_TRACK ) {
                                wdc_send_error();
                            } else {
                                errorcode = wdc_add_btt_entry ( cmd_buffer[2] | ( cmd_buffer[3] << 8 ), cmd_buffer[4] );
                                if ( errorcode > 0 ) {
                                    wdc_send_errorcode ( errorcode );
                                } else {
                                    data_buffer[0] = cmd_buffer[2]; /* Track Low */
                                    data_buffer[1] = cmd_buffer[3]; /* Track High */
                                    data_buffer[2] = cmd_buffer[4]; /* Head */

                                    wdc_send_data ( data_buffer
                                                  , 3
                                                  );
                                }
                            }
                        }
                        break;

                    case CMD_ST_PARBTT:
                        blockno = 0;
                        wdc_set_disk_valid();
                        wdc_read_par_table ( data_buffer
                                           , WDC_BLOCKLEN );

                        errorcode = wdc_write_sector ( blockno, data_buffer );
                        if ( errorcode > 0 ) {
                            wdc_send_error();
                        }
                        break;

                    case CMD_RD_WDCERR:
                        data_counter = ( cmd_buffer[7] << 8 ) | cmd_buffer[6];

                        memset ( &data_buffer[0], 0x00, data_counter );
                        wdc_send_data ( data_buffer
                                      , data_counter
                                      );
                        break;

                    case CMD_VER_TRACK:
                        blockno = wdc_sector2diskblock ( cmd_buffer[2] | ( cmd_buffer[3] << 8 )
                                                       , cmd_buffer[4]
                                                       , cmd_buffer[5]
                                                       );

                        errorcode = wdc_validate_cylhead ( cmd_buffer[2] | ( cmd_buffer[3] << 8 ), cmd_buffer[4], blockno );
                        if ( errorcode != 0 ) {
                            wdc_send_errorcode ( errorcode );
                            break;
                        }

                        errorcode = 1;
                        for ( i8 = 0; i8 < wdc_get_hdd_sectors(); i8++ ) {
                            errorcode = wdc_read_sector ( blockno, data_buffer );
                            if ( errorcode > 0 ) {
                                break;
                            }
                            blockno++;
                        }

                        if ( errorcode > 0 ) {
                            wdc_send_error();
                        }
                        break;

                    case CMD_RD_SECTOR:
                        data_counter = ( cmd_buffer[7] << 8 ) | cmd_buffer[6];

                        blockno = wdc_sector2diskblock ( cmd_buffer[2] | ( cmd_buffer[3] << 8 )
                                                       , cmd_buffer[4]
                                                       , cmd_buffer[5]
                                                       );

                        errorcode = wdc_validate_cylhead ( cmd_buffer[2] | ( cmd_buffer[3] << 8 ), cmd_buffer[4], blockno );
                        if ( errorcode != 0 ) {
                            wdc_send_errorcode ( errorcode );
                            break;
                        }

                        if ( data_counter == WDC_BLOCKLEN ) {
                            errorcode = wdc_read_sector ( blockno, data_buffer );
                        } else {
                            errorcode = wdc_read_multiblock ( blockno, data_buffer, data_counter / WDC_BLOCKLEN );
                        }

                        if ( errorcode > 0 ) {
                            wdc_send_error();
                        } else {
                            wdc_send_data ( data_buffer
                                          , data_counter
                                          );
                        }
                        break;
                    case CMD_WR_SECTOR:
                        data_counter = ( cmd_buffer[7] << 8 ) | cmd_buffer[6];

                        blockno = wdc_sector2diskblock ( cmd_buffer[2] | ( cmd_buffer[3] << 8 )
                                                       , cmd_buffer[4]
                                                       , cmd_buffer[5]
                                                       );

                        errorcode = wdc_validate_cylhead ( cmd_buffer[2] | ( cmd_buffer[3] << 8 ), cmd_buffer[4], blockno );
                        if ( errorcode != 0 ) {
                            wdc_send_errorcode ( errorcode );
                            break;
                        }

                        wdc_receive_data ( data_buffer
                                         , data_counter
                                         );

                        if ( data_counter == WDC_BLOCKLEN ) {
                            errorcode = wdc_write_sector ( blockno, data_buffer );
                        } else {
                            errorcode = wdc_write_multiblock ( blockno, data_buffer, data_counter / WDC_BLOCKLEN );
                        }

                        if ( errorcode > 0 ) {
                            wdc_send_error();
                        }
                        break;

                    default:
#if DEBUG >= 1
                        uart_putstring ( PSTR ( "ERROR: Unknown command received from the P8000:" ), false );
                        uart_putc_hex ( cmd_buffer[0] );
                        uart_putc_hex ( cmd_buffer[1] );
                        uart_putc_hex ( cmd_buffer[2] );
                        uart_putc_hex ( cmd_buffer[3] );
                        uart_putc_hex ( cmd_buffer[4] );
                        uart_putc_hex ( cmd_buffer[5] );
                        uart_putc_hex ( cmd_buffer[6] );
                        uart_putc_hex ( cmd_buffer[7] );
                        uart_putc_hex ( cmd_buffer[8] );
                        uart_put_nl();
#endif

                        wdc_send_error();
                        break;
                }
            }
        }
    }
#endif
    return 0;
}

static void atmega_setup ( void )
{
    set_sleep_mode ( SLEEP_MODE_IDLE );

    wdc_led_bootup();

    _delay_ms ( 3000 );

    wdc_init_avr();
    uart_init();

    uart_putstring ( PSTR ( "=== P8000 WDC Emulator 2.10 - 2016-07-02 ===" ), true );
    wdc_get_sysconf();

    if ( wdc_init_disk() != 0 ) {
        uart_putstring ( PSTR ( "ERROR: No disk found!" ), true );
        wdc_set_no_disk();
    }

    wdc_set_initialized();
}
