OlliL/P8000_WDC_Emulator/P8000_WDC_Emulator/wdc_drv_pata.c

/*-
 * Copyright (c) 2012, 2013, 2015, 2016 Oliver Lehmann
 * All rights reserved.
 *
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
 */

#include "wdc_config.h"
#include <stdbool.h>
#include <avr/pgmspace.h>
#include <avr/io.h>
#include <util/delay.h>
#include "wdc_avr.h"
#include "wdc_drv_pata.h"
#include "wdc_types.h"
#include "uart.h"

static void    deactivate_p8000com();
static void    activate_p8000com();
static bool    pata_bsy ();
static bool    pata_rdy ();
static bool    pata_drq ();
static uint8_t pata_err ();
static uint8_t ata_identify ();
static void    set_io_register ( uint8_t ioreg );
static uint8_t read_io_register ( uint8_t ioreg );
static void    write_io_register ( uint8_t ioreg, uint8_t byte );
static void    pata_read_bytes ( /*@out@*/ uint8_t *buffer, uint8_t numblocks );
static void    pata_write_bytes ( uint8_t *buffer, uint8_t numblocks );

/*
 *                                                  +---- DA2
 *                                                  |+--- DA1
 *                                                  ||+-- DA0
 *                                                  |||+- CS0
 * Command Block registers                          |||| */
#define PATA_RW_DATA_REGISTER            0x00  /* 0b0000 */
#define PATA_R_ERROR_REGISTER            0x02  /* 0b0010 */
#define PATA_W_FEATURE_REGISTER          0x02  /* 0b0010 */
#define PATA_RW_SECTOR_COUNT_REGISTER    0x04  /* 0b0100 */
#define PATA_RW_SECTOR_NUMBER_REGISTER   0x06  /* 0b0110 */
#define PATA_RW_CYLINDER_LOW_REGISTER    0x08  /* 0b1000 */
#define PATA_RW_CYLINDER_HIGH_REGISTER   0x0A  /* 0b1010 */
#define PATA_RW_DEVICE_HEAD_REGISTER     0x0C  /* 0b1100 */
#define PATA_R_STATUS_REGISTER           0x0E  /* 0b1110 */
#define PATA_W_COMMAND_REGISTER          0x0E  /* 0b1110 */

/* Control Block Registers */
#define PATA_W_DEVICE_CONTROL_REGISTER   0x0D  /* 0b1101 */
#define PATA_R_ALTERNATE_STATUS_REGISTER 0x0D  /* 0b1101 */

typedef struct {
    uint16_t cylinders;
    uint16_t heads;
    uint16_t sectors;
    uint32_t sizeinsectors;
    bool LBAsupport;
} typeDriveInfo;

static typeDriveInfo ataDriveInfo;
static uint8_t       p8000_info_restore;

static void deactivate_p8000com ()
{
    disable_p8000com();

    nop();
    nop();

    p8000_info_restore = PORT_INFO;
}

static void activate_p8000com ()
{
    ata_wr_disable();
    ata_rd_disable();
    wdc_config_p8000_ports();

    PORT_INFO = p8000_info_restore;

    nop();
    nop();

    enable_p8000com();
}

static bool inline pata_rdy ()
{
    return (( read_io_register ( PATA_R_STATUS_REGISTER ) & ATA_STAT_RDY ) == ATA_STAT_RDY ) ? true : false;
}

static bool inline pata_bsy ()
{
    return ( ( read_io_register ( PATA_R_STATUS_REGISTER ) & ATA_STAT_BSY ) == ATA_STAT_BSY ) ? true : false;
}

static bool inline pata_drq ()
{
    return (( read_io_register ( PATA_R_STATUS_REGISTER ) & ATA_STAT_DRQ ) == ATA_STAT_DRQ )  ? true : false;
}

static uint8_t inline pata_err ()
{
    if ( ( read_io_register ( PATA_R_STATUS_REGISTER ) & ATA_STAT_ERR ) == ATA_STAT_ERR ) {
        return read_io_register ( PATA_R_ERROR_REGISTER );
    }
    return (uint8_t)0;
}

static void inline set_io_register ( uint8_t ioreg )
{
    /* set the requested signals */
    PORT_ATADA = PORT_ATADA & 0xf0;               /* Clear previous signals (lower 4 bits of PORT_ATADA)  */
    PORT_ATADA = PORT_ATADA | ( ioreg & 0x0f );   /* Assert the signal Lines (lower 4 bits of PORT_ATADA) */
}

static uint8_t inline read_io_register ( uint8_t ioreg )
{
    uint8_t byte;

    configure_ata_data_read();

    set_io_register ( ioreg );
    ata_rd_enable();
    /* assert 296ns */
    nop();
    nop();
    nop();
    byte = port_ata_data_8l_get();
    ata_rd_disable();

    return byte;
}

static void inline write_io_register ( uint8_t ioreg, uint8_t byte )
{
    configure_ata_data_write();

    set_io_register ( ioreg );
    port_ata_data_8l_set ( byte );
    ata_wr_enable();
    /* assert 296ns */
    nop();
    nop();
    nop();
    nop();
    ata_wr_disable();
}

static void pata_read_bytes ( /*@out@*/ uint8_t *buffer, uint8_t numblocks )
{
    uint8_t i = 0;

    configure_ata_data_read();

    do {
        while ( pata_bsy() ) {}
        if ( pata_err() > 0 ) {
            return;
        }
        while ( !pata_drq() ) {}

        set_io_register ( PATA_RW_DATA_REGISTER );

        do {
            ata_rd_enable();
            nop();
            nop();
            *buffer++ = port_ata_data_8l_get();
            *buffer++ = port_ata_data_8h_get();
            ata_rd_disable();
        } while ( ++i != 0 ); /* overflow, 512 bytes read */
    } while ( --numblocks > 0 );
}

static void pata_write_bytes ( uint8_t *buffer, uint8_t numblocks )
{
    uint8_t i = 0;

    do {
        while ( pata_bsy() ) {}
        if ( pata_err() > 0 ) {
            return;
        }
        while ( !pata_drq() ) {}

        configure_ata_data_write();

        set_io_register ( PATA_RW_DATA_REGISTER );

        do {
            port_ata_data_8l_set ( *buffer++ );
            port_ata_data_8h_set ( *buffer++ );
            ata_wr_enable();
            nop();
            nop();
            ata_wr_disable();
        } while ( ++i != 0 );  /* overflow, 512 bytes written */
    } while ( --numblocks > 0 );
}

static uint8_t ata_identify ()
{
    uint8_t  buffer[512], i;
    uint16_t word[256], n;

    write_io_register ( PATA_W_COMMAND_REGISTER, CMD_IDENTIFY_DEVICE );

    pata_read_bytes ( buffer, 1 );
    if ( pata_err() > 0 ) {
        return 1;
    }

    i = 0;
    for ( n = 0; n < 512; n += 2 ) {
        word[i] = ( ( buffer[n + 1] << 8 ) | buffer[n] );
        i++;
    }

    /* check if data is nonsense */
    if ( word[1] == word[3] ) {
        return 2;
    }

    ataDriveInfo.cylinders = word[1];
    ataDriveInfo.heads = word[3];
    ataDriveInfo.sectors = word[6];
    ataDriveInfo.LBAsupport = ( word[53] & ( 1 << 0 )) == 1 ? true : false;

    if ( !ataDriveInfo.LBAsupport ) {
        ataDriveInfo.sizeinsectors = ataDriveInfo.cylinders * ataDriveInfo.heads * ataDriveInfo.sectors;
    } else {
        ataDriveInfo.sizeinsectors = word[60] | (uint32_t)word[61] << 16;
    }

    uart_putstring ( PSTR ( "INFO: PATA disk has been found" ), true );
    uart_putstring ( PSTR ( "INFO: Number of logical cylinders: " ), false );
    uart_putw_dec ( word[1] );
    uart_put_nl();
    uart_putstring ( PSTR ( "INFO: Number of logical heads: " ), false );
    uart_putw_dec ( word[3] );
    uart_put_nl();
    uart_putstring ( PSTR ( "INFO: Number of logical sectors per logical track: " ), false );
    uart_putw_dec ( word[6] );
    uart_put_nl();
    uart_putstring ( PSTR ( "INFO: Serial number: " ), false );
    for ( i = 10; i <= 19; i++ ) {
        uart_putc ( word[i] >> 8 );
        uart_putc ( word[i] & 0x00FF );
    }
    uart_put_nl();
    uart_putstring ( PSTR ( "INFO: Firmware revision: " ), false );
    for ( i = 23; i <= 26; i++ ) {
        uart_putc ( word[i] >> 8 );
        uart_putc ( word[i] & 0x00FF );
    }
    uart_put_nl();
    uart_putstring ( PSTR ( "INFO: Model number: " ), false );
    for ( i = 27; i <= 46; i++ ) {
        uart_putc ( word[i] >> 8 );
        uart_putc ( word[i] & 0x00FF );
    }
    uart_put_nl();
    uart_putstring ( PSTR ( "INFO: Capabilities: " ), false );
    if ( ( word[49] & ( 1 << 8 )) > 0 ) {
        uart_putstring ( PSTR ( "DMA, " ), false );
    }
    if ( ( word[49] & ( 1 << 9 )) > 0 ) {
        uart_putstring ( PSTR ( "LBA, " ), false );
    }
    if ( ( word[49] & ( 1 << 10 )) > 0 ) {
        uart_putstring ( PSTR ( "IORDY may be disabled, " ), false );
    }
    if ( ( word[49] & ( 1 << 11 )) > 0 ) {
        uart_putstring ( PSTR ( "IORDY, " ), false );
    }
    if ( ( word[49] & ( 1 << 13 )) > 0 ) {
        uart_putstring ( PSTR ( "Standard standby timer values, " ), false );
    }
    uart_put_nl();

    if ( ( word[53] & ( 1 << 0 )) > 0 ) {
        uart_putstring ( PSTR ( "INFO: Number of current logical cylinders: " ), false );
        uart_putw_dec ( word[54] );
        uart_put_nl();
        uart_putstring ( PSTR ( "INFO: Number of current logical heads: " ), false );
        uart_putw_dec ( word[55] );
        uart_put_nl();
        uart_putstring ( PSTR ( "INFO: Number of current logical sectors per track: " ), false );
        uart_putw_dec ( word[56] );
        uart_put_nl();
        uart_putstring ( PSTR ( "INFO: Current capacity in sectors: " ), false );
        uart_putdw_dec ( word[57] | (uint32_t)word[58] << 16 );
        uart_put_nl();
    }
    if ( ( word[53] & ( 1 << 1 )) > 0 ) {
        uart_putstring ( PSTR ( "INFO: User addressable sectors for 28-bit commands: " ), false );
        uart_putdw_dec ( word[60] | (uint32_t)word[61] << 16 );
        uart_put_nl();
        uart_putstring ( PSTR ( "INFO: Single Word DMA modes: " ), false );
        uart_putw_dec ( word[62] );
        uart_put_nl();
        uart_putstring ( PSTR ( "INFO: Multiword Word DMA modes: " ), false );
        uart_putw_dec ( word[63] );
        uart_put_nl();
        uart_putstring ( PSTR ( "INFO: PIO modes: " ), false );
        uart_putw_dec ( word[64] );
        uart_put_nl();
        uart_putstring ( PSTR ( "INFO: Minimum Multiword DMA cycle time per word: " ), false );
        uart_putw_dec ( word[65] );
        uart_putstring ( PSTR ( "ns" ), true );
        uart_putstring ( PSTR ( "INFO: Recommended Multiword DMA cycle time: " ), false );
        uart_putw_dec ( word[66] );
        uart_putstring ( PSTR ( "ns" ), true );
        uart_putstring ( PSTR ( "INFO: Minimum PIO transfer cycle time without flow control: " ), false );
        uart_putw_dec ( word[67] );
        uart_putstring ( PSTR ( "ns" ), true );
        uart_putstring ( PSTR ( "INFO: Minimum PIO cycle time with IORDY flow control: " ), false );
        uart_putw_dec ( word[68] );
        uart_putstring ( PSTR ( "ns" ), true );
        uart_putstring ( PSTR ( "INFO: Additional support: " ), false );
        uart_putw_dec ( word[69] );
        uart_put_nl();
    }
    if ( ( word[53] & ( 1 << 2 )) > 0 ) {
        uart_putstring ( PSTR ( "INFO: Ultra DMA modes: " ), false );
        uart_putw_dec ( word[88] );
        uart_put_nl();
    }

    return 0;
}

static void inline pata_rw_command_chs ( uint8_t head, uint8_t numblocks, uint8_t sector, uint8_t cylhigh, uint8_t cyllow, uint8_t cmd )
{
    while ( pata_bsy() ) {}
    while ( pata_drq() ) {}

    write_io_register ( PATA_RW_DEVICE_HEAD_REGISTER, head );
    write_io_register ( PATA_RW_SECTOR_COUNT_REGISTER, numblocks );
    write_io_register ( PATA_RW_SECTOR_NUMBER_REGISTER, sector );
    write_io_register ( PATA_RW_CYLINDER_HIGH_REGISTER, cylhigh );
    write_io_register ( PATA_RW_CYLINDER_LOW_REGISTER, cyllow );

    write_io_register ( PATA_W_COMMAND_REGISTER, cmd );
}

static void pata_rw_command_block ( uint32_t addr, uint8_t numblocks, uint8_t cmd )
{
    sint32  startblock;
    uint8_t sector, cyllow, cylhigh, head;
    sint16  cylinder;

    if ( ataDriveInfo.LBAsupport ) {
        startblock.value32 = addr;
        sector = startblock.value8.ll;
        cyllow = startblock.value8.lh;
        cylhigh = startblock.value8.hl;
        head = ( startblock.value8.hh & 0x0F ) | ATA_LBA_DRIVE_0;
    } else {
        sector = ( addr % ataDriveInfo.sectors ) + 1;
        addr = addr / ataDriveInfo.sectors;
        head = ATA_CHS_DRIVE_0 + ( addr % ataDriveInfo.heads );
        addr = addr / ataDriveInfo.heads;
        cylinder.value16 = addr;
        cylhigh = cylinder.value8.h;
        cyllow = cylinder.value8.l;
    }

    pata_rw_command_chs ( head, numblocks, sector, cylhigh, cyllow, cmd );
}

uint8_t pata_init ()
{
    uint8_t wait_for_drive = 50;
    uint8_t ret;

    deactivate_p8000com();

    uart_putstring ( PSTR ( "INFO: PATA init start" ), true );
    while ( !pata_rdy() ) {
        if ( --wait_for_drive == 0 ) {
            uart_put_nl();
            ret = 1;
            goto out;
        }
        uart_putc ( 'r' );
        _delay_ms ( 500 );
    }

    wait_for_drive = 50;

    while ( pata_bsy() ) {
        if ( --wait_for_drive == 0 ) {
            uart_put_nl();
            ret = 1;
            goto out;
        }
        uart_putc ( 'b' );
        _delay_ms ( 500 );
    }

    uart_put_nl();

    write_io_register ( PATA_RW_DEVICE_HEAD_REGISTER, ATA_CHS_DRIVE_0 );

    ret = ata_identify();

    if ( ret == 0 ) {
        /* this is needed for my WD31600 harddisk */
        pata_rw_command_chs ( ATA_CHS_DRIVE_0, 0, 0, 0, 0, CMD_RECALIBRATE );
        pata_rw_command_chs ( ATA_CHS_DRIVE_0 + ataDriveInfo.heads - 1, ataDriveInfo.sectors, 0, 0, 0, CMD_INITIALIZE_DRIVE );
        while ( pata_bsy() ) {}
    }

out:
    activate_p8000com();
    return ret;
}

uint8_t pata_read_block ( uint32_t addr, uint8_t *buffer )
{
    return pata_read_multiblock ( addr, buffer, 1 );
}

uint8_t pata_write_block ( uint32_t addr, uint8_t *buffer )
{
    return pata_write_multiblock ( addr, buffer, 1 );
}

uint8_t pata_read_multiblock ( uint32_t addr, uint8_t *buffer, uint8_t numblocks )
{
    uint8_t ret;

    deactivate_p8000com();

    pata_rw_command_block ( addr, numblocks, CMD_READ_SECTORS );

    pata_read_bytes ( buffer, numblocks );

    ret = pata_err();

    activate_p8000com();

    return ret;
}

uint8_t pata_write_multiblock ( uint32_t addr, uint8_t *buffer, uint8_t numblocks )
{
    uint8_t ret;

    deactivate_p8000com();

    pata_rw_command_block ( addr, numblocks, CMD_WRITE_SECTORS );

    pata_write_bytes ( buffer, numblocks );

    /* wait until drive completed write */
    while ( pata_bsy() ) {}

    ret = pata_err();

    activate_p8000com();

    return ret;
}
