OlliL/P8000_WDC_Emulator/(commit log)

2011-12-27 /RESET fix
    [P8000_WDC_Emulator.sch]
2012-05-06 use 74HCT125 instead of resister network
    [P8000_WDC_Emulator.sch]
2012-05-06 restors again
    [P8000_WDC_Emulator.sch]
2012-05-26 P8000 Interface
    [P8000_WDC_Emulator.sch]
2012-05-26 TR ans ASTB have to be driven
    [P8000_WDC_Emulator.sch]
2012-05-26 reorder Port-C
    [P8000_WDC_Emulator.sch]
2012-05-29 add current PDF Output
2012-05-31 - split up monolith main.c into several files - implementation of the following commands:
    #define CMD_RD_PARTAB 0x28 /* P8000 Command: read Parameter block from WDC RAM */
    #define CMD_WR_PARTAB 0x78 /* P8000 Command: write Parameter block to WDC RAM */
    #define CMD_DL_BTTAB 0x48 /* P8000 Command: delete Bad Track Table from WDC RAM */
    #define CMD_RD_BTTAB 0x58 /* P8000 Command: read Bad Track Table from WDC RAM */
    #define CMD_WR_BTTAB 0x68 /* P8000 Command: write Bad Track Table to WDC RAM */
2012-06-03 - make ALLOC optional (will be removed in next commit) - implement SPI-CRC (CRC routines not yet reviewed for improvements)
2012-06-05 complete overhaul and reimplementation of the MMC Code Implement Checksumming Implement Multiblock-Operation Also increase performance by reducing function calls for SPI handling
2012-06-05 make data buffers global to get a better overview of SRAM usage during compile time. when detecting an error during Reading Blocks from the "WDC", respond only with an error message - not with error+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
    [wdc_if_p8000.c, wdc_main.c]
2012-06-09 add SDHC support rework PAR+BTT system to match the original P8000 behaviour
    [wdc_config.h, wdc_drv_mmc.c, wdc_if_disk.c, wdc_if_disk_perf.c, wdc_if_p8000.h, wdc_main.c, wdc_main.h, wdc_par.c]
2012-06-09 first step for a ATA implementation
    [P8000_WDC_Emulator.sch]
2012-06-10 more work on the circuit
    [P8000_WDC_Emulator.sch]
2012-06-10 error correction
    [P8000_WDC_Emulator.sch]
2012-06-10 P8000-Acessing via '138+'245
    [P8000_WDC_Emulator.sch]
2012-06-12 First step towards PATA support. Rename files to better fit into the architecture
    [P8000_WDC_Emulator.sch]
2012-06-13 implement jumper reading assign function pointers for PATA functions, or MMC functions depending on the jumper setting move a '04 gate in the circuit diagram from one slot to another
    [P8000_WDC_Emulator.sch]
2012-06-15 first work on PATA
    [P8000_WDC_Emulator.sch]
2012-06-16 sync with reality
    [P8000_WDC_Emulator.sch]
2012-06-16 PATA should work now
    [P8000_WDC_Emulator.sch]
2012-06-18 fix errors connect MMC-/CS to '138
    [P8000_WDC_Emulator.sch]
2012-06-20 remove gschem stuff
    [P8000_WDC_Emulator.sch]
2012-06-20 welcome KiCad version
    [P8000_WDC_Emulator.sch]
2012-06-20 more work
    [P8000_WDC_Emulator.sch]
2012-06-21 todays work
    [P8000_WDC_Emulator.brd, P8000_WDC_Emulator.sch]
2012-06-22 more work!
    [P8000_WDC_Emulator.brd, P8000_WDC_Emulator.sch]
2012-06-22 more and more final
    [P8000_WDC_Emulator.brd, P8000_WDC_Emulator.sch]
2012-06-22 little details
    [P8000_WDC_Emulator.brd]
2012-06-22 6x6 switch some 3D models
    [P8000_WDC_Emulator.brd]
2012-06-23 fix EFS connector
    [P8000_WDC_Emulator.brd]
2012-06-24 move C4 a little bit to the left for the IDE plug
    [P8000_WDC_Emulator.brd]
2012-06-24 fix Unconnected Check
    [P8000_WDC_Emulator.brd]
2012-06-25 newer version
    [P8000_WDC_Emulator.brd]
2012-06-25 change EFS26 connector
    [P8000_WDC_Emulator.brd]
2012-06-25 add parts list
    [P8000_WDC_Emulator_Parts.ods]
2012-06-26 better version - bigger VCC,GND some C moved
    [P8000_WDC_Emulator.brd]
2012-06-26 new version
    [P8000_WDC_Emulator.brd]
2012-06-26 filled area with GND
    [P8000_WDC_Emulator.brd]
2012-06-26 last work
    [P8000_WDC_Emulator.brd]
2013-04-20 move /CS signal from '138 back to AT-Mega fix several issues on the board and the schematic. From my recollection:
    - add to the back solder mask (solder pads on the back where missing):
    - Mini DIN 6
    - LEDs
    - switch 5V and 12V of the MOLEX connector
    - switch DATAIN and DATAOUT connections of the SD-Card
    - Rotate Transistor graphic to indicate how the TO92 transistor has to be placed
    - correct resistor namings (R6, 3R4)
    - add jumper JP5 for /RST generation when the EFS connector is in use
    - move the SPI and the HDD-power socket to the right
    - enlarge the holes for the MOLEX and the HDD-power connectors
    - enlarge the fixating hole of the MOLEX connector
    - add polarisation indicators (Silk) f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
    [P8000_WDC_Emulator.brd, P8000_WDC_Emulator.sch, P8000_WDC_Emulator_Parts.ods]
2013-04-21 update part list with reality
    [P8000_WDC_Emulator_Parts.ods]
2013-04-21 rout /RST through '03 for supporting the P8000 Compact and P8000
    [P8000_WDC_Emulator.brd, P8000_WDC_Emulator.sch]
2013-04-23 small changes like connecting open gates of the '04 and '03 change hdd-spinup timer from 200ms to 400ms as this feels more stable remove nop() comments
    [P8000_WDC_Emulator.brd, P8000_WDC_Emulator.sch]
2013-04-28 latest version (v1.2)
    [P8000_WDC_Emulator.brd, P8000_WDC_Emulator_Parts.ods]
2013-05-03 reimplementation of uart stuff for BSD licensing better debug output tweaked AStyle formatting
    [P8000_WDC_Emulator_Parts.ods]
2013-05-04 formatting is now done with uncrustify move to a BSD licensed uart.[ch]
2013-05-04 format the code using uncrustify migrate uart.[ch] to a BSD style license by reimplementing it
2013-05-07 general delay on startup fix SDCard init message
    [wdc_drv_mmc.c, wdc_drv_pata.c, wdc_main.c]
2013-05-18 remove DB25 + EFS header add two 2x13 header
    [P8000_WDC_Emulator.brd, P8000_WDC_Emulator.sch]
2013-06-10 move LEDs a bit more to the outside
    [P8000_WDC_Emulator.brd]
2013-07-12 missing connection
    [P8000_WDC_Emulator.brd]
2013-07-13 smaler layout
    [P8000_WDC_Emulator.brd]
2013-09-04 some small corrections (only labels)
    [P8000_WDC_Emulator.brd, P8000_WDC_Emulator_Parts.ods]
2013-09-04 Title auf v1.2 setzen
    [P8000_WDC_Emulator.sch]
2015-11-30 board version 1.3 software version 0.93
    [P8000_WDC_Emulator.brd, P8000_WDC_Emulator.sch]
2015-11-30 note fuses
2015-12-04 version 1.3 (hw) 0.93 (soft)
    [P8000_WDC_Emulator.brd, P8000_WDC_Emulator.sch]
2015-12-05 more work on solving several bugs
    [wdc_config.h, wdc_drv_mmc.c, wdc_drv_pata.c, wdc_main.c, wdc_par.c]
2015-12-15 work on 2.x
    [P8000_WDC_Emulator.sch]
2015-12-18 continue work on version 2.0
    [P8000_WDC_Emulator_Parts.ods]
2015-12-18 bump to version 2.0
    [P8000_WDC_Emulator_Parts.ods]
2015-12-21 latest circuit diagram
2015-12-21 start PCB
    [P8000_WDC_Emulator.brd, P8000_WDC_Emulator.sch, P8000_WDC_Emulator_Parts.ods]
2015-12-21 basic board layout
    [P8000_WDC_Emulator.brd]
2015-12-21 basic board
    [P8000_WDC_Emulator.brd, P8000_WDC_Emulator.dsn]
2015-12-21 switch left and right
    [P8000_WDC_Emulator.brd, P8000_WDC_Emulator.dsn]
2015-12-22 revert to own SD-Card Connector instead of SD-Module
2015-12-23 make splint happier
    [P8000_WDC_Emulator.brd, P8000_WDC_Emulator.dsn, P8000_WDC_Emulator.sch]
2015-12-30 on the way to perfection.....
    [P8000_WDC_Emulator.brd, P8000_WDC_Emulator.sch, P8000_WDC_Emulator_Parts.ods]
2015-12-30 fix my "special" IDE harddrive + fix sa.format
    [wdc_avr.h, wdc_drv_pata.c, wdc_drv_pata.h, wdc_if_p8000.c]
2015-12-31 add descriptions, add ground fill, save some vias
    [P8000_WDC_Emulator.brd]
2015-12-31 implement validating block, cylinder and heads given by the host
2015-12-31 switch MAX3232 to MAX232
    [P8000_WDC_Emulator.brd, P8000_WDC_Emulator.sch, P8000_WDC_Emulator_Parts.ods]
2016-01-01 move SD-Card connector a bit into the PCB to make ejecting easier
    [P8000_WDC_Emulator.brd]
2016-01-02 add LA captures, rename some #defines, move port set before /ASTB assertion
    [P8000_Emulator_CMD_21_OK.csv, P8000_Emulator_CMD_22_OK.csv, P8000_WDC_CMD_21_InvalidBlock_Error_05.csv, P8000_WDC_CMD_21_InvalidDisk_Error_03.csv, P8000_WDC_CMD_21_OK.csv, P8000_WDC_CMD_22_OK.csv, P8000_WDC_Firmware_Selftest.csv, P8000_WDC_sa_format_startup.csv]
2016-01-02 add some more signal traces
    [P8000_Emulator_CMD_28_OK.csv, P8000_WDC_Bootup.csv, P8000_WDC_Copy_File.csv, P8000_WDC_sa_shipdisk.csv]
2016-01-03 implement CMD_WR_SECTOR which is used by sa.diags and fix CMD_RD_SECTOR which actually reads a sector and not writes it!
    [wdc_main.c, wdc_main.h]
2016-01-17 Revert "work around noisy signals by checking them twice"
    This reverts commit b78b27b0f580e8aef01c8daa54060933d523ba7f.
    [wdc_if_p8000.c, wdc_main.c]
2016-01-17 update emulator caputres, remove wrong VCD files
    [P8000_Emulator_CMD_21_OK.csv, P8000_Emulator_CMD_22_OK.csv, P8000_Emulator_CMD_28_OK.csv]
2016-01-17 activate pull up resistors on /RDY and /ASTB
2016-01-18 Revert "Revert "work around noisy signals by checking them twice""
    This reverts commit ee54e2ec47cce5338274c584df270881974b5781.
    [wdc_if_p8000.c, wdc_main.c]
2016-01-24 some more work to make it a bit nicer
    [P8000_WDC_Emulator.brd]
2016-01-30 migrate to KiCAD 4.0.1
    [P8000_WDC_Emulator.brd, P8000_WDC_Emulator.dsn, P8000_WDC_Emulator.kicad_pcb]
2016-01-30 update 3D and footprints
    [P8000_WDC_Emulator.kicad_pcb, P8000_WDC_Emulator.sch]
2016-01-30 add kicad_pcb.bak
2016-01-30 nothing important changed
    [P8000_WDC_Emulator.kicad_pcb]
2016-02-04 more ground layer
    [P8000_WDC_Emulator.kicad_pcb]
2016-03-15 rearrange resistor labels to prevent wrong placement
    [P8000_WDC_Emulator.kicad_pcb, P8000_WDC_Emulator_Parts.ods]
2016-03-15 change release date
    [P8000_WDC_Emulator.kicad_pcb]
2016-03-15 matching Gerber exports
    [P8000_WDC_Emulator-B.Mask.gbs, P8000_WDC_Emulator-Back.gbl, P8000_WDC_Emulator-Edge.Cuts.gm1, P8000_WDC_Emulator-F.Mask.gts, P8000_WDC_Emulator-F.Paste.gtp, P8000_WDC_Emulator-F.SilkS.gto, P8000_WDC_Emulator-Front.gtl, P8000_WDC_Emulator-NPTH-drl_map.gbr]
2016-03-26 power line sizes for 3.3V
    [P8000_WDC_Emulator.kicad_pcb]
2016-04-16 begin work on v2.1
    [P8000_WDC_Emulator.kicad_pcb, P8000_WDC_Emulator.sch]
2016-04-30 version 2.1
    [P8000_WDC_Emulator-B.Mask.gbs, P8000_WDC_Emulator-Back.gbl, P8000_WDC_Emulator-Edge.Cuts.gm1, P8000_WDC_Emulator-F.Mask.gts, P8000_WDC_Emulator-F.Paste.gtp, P8000_WDC_Emulator-F.SilkS.gto, P8000_WDC_Emulator-Front.gtl, P8000_WDC_Emulator-NPTH-drl_map.gbr]
2016-07-02 version 2.10
    [P8000_WDC_Emulator-B.Mask.gbs, P8000_WDC_Emulator-Back.gbl, P8000_WDC_Emulator-Edge.Cuts.gm1, P8000_WDC_Emulator-F.Mask.gts, P8000_WDC_Emulator-F.Paste.gtp, P8000_WDC_Emulator-F.SilkS.gto, P8000_WDC_Emulator-Front.gtl, P8000_WDC_Emulator-NPTH-drl_map.gbr]
2016-07-02 update stuff
    [P8000_WDC_Emulator_Parts.ods]
2016-07-04 SPI clocking modes comment
2016-07-24 update performance
    [P8000_WDC_Emulator_Parts.ods]
2016-08-15 remove outplaced label, fix resistor-drill dimension
    [P8000_WDC_Emulator-B.Mask.gbs, P8000_WDC_Emulator-Back.gbl, P8000_WDC_Emulator-Edge.Cuts.gm1, P8000_WDC_Emulator-F.Mask.gts, P8000_WDC_Emulator-F.Paste.gtp, P8000_WDC_Emulator-F.SilkS.gto, P8000_WDC_Emulator-Front.gtl, P8000_WDC_Emulator-NPTH-drl_map.gbr]
2016-08-27 add missing part, C7 was renamed to C2 at some point in time
    [P8000_WDC_Emulator.sch, P8000_WDC_Emulator_Parts.ods]
